mmontee/West_Lab_Hydrophone_Data_Logger/Hardware/kiCAD/IMG_20241230_154832218.jpg

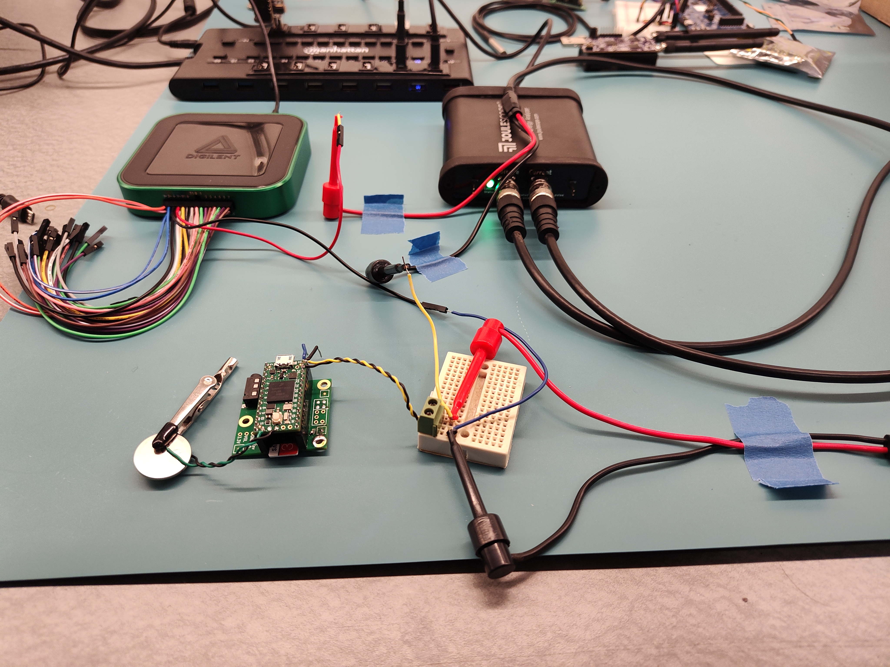
Hardware/kiCAD/IMG_20241230_154832218.jpg
