mmontee/West_Lab_Hydrophone_Data_Logger/Hardware/kiCAD/IMG_20241231_141157989.jpg

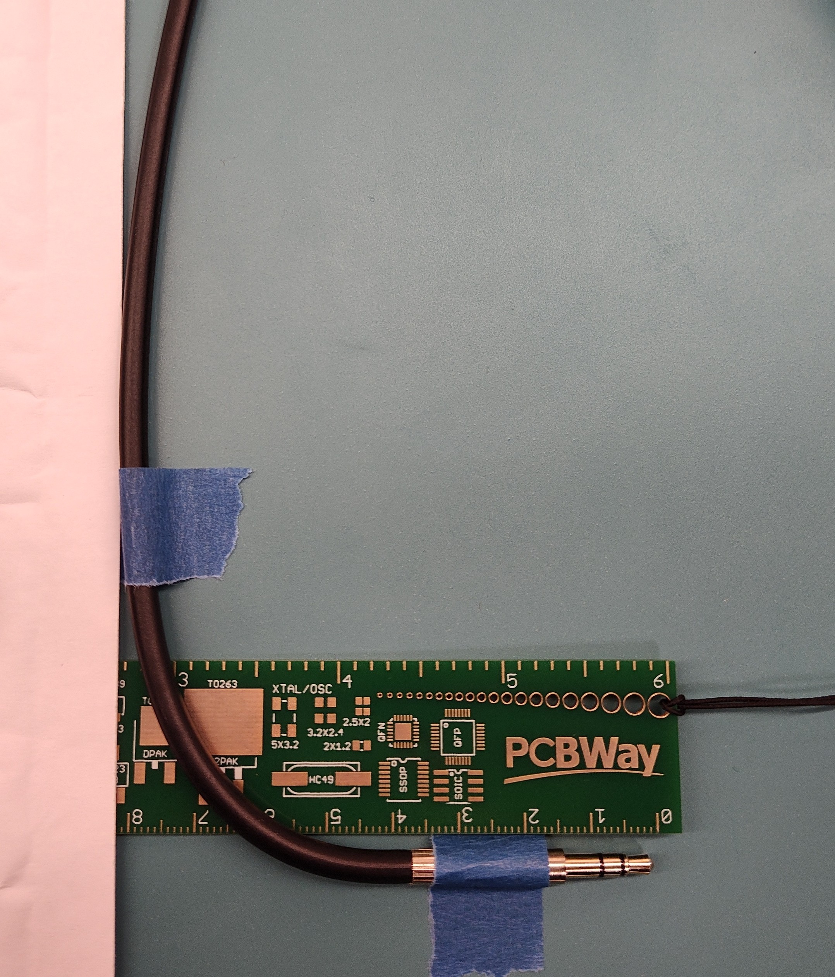
Hardware/kiCAD/IMG_20241231_141157989.jpg
