mmontee/West_Lab_Hydrophone_Data_Logger/West Lab Hydrophone Data Logger Bom .pdf

| | | | | | Total Price: | $105.50
Item | Description | Vendor | Vendor Part Number | Item Link | Quantity | Unit Price | Item(s) Price
208-4 | Dip Switch | DigiKey | CT2084-ND | 208-4 CTS Electrocomponents (https://www.digikey.com/en/products/detail/cts-electrocomponents/208-4/20783) | Switches | DigiKey 1 | $0.78 | $0.78
SJ1-3533NS | 3.5mm TRS | DigiKey | CP1-3533NS-ND | https://www.digikey.com/en/products/detail/same-sky-formerly-cui-devices/SJ1-3533NS/659904 2 | $1.59 | $3.18
2465 | Adafruit Powerboost 1A | DigiKey | 1528-1349-ND | https://www.digikey.com/en/products/detail/adafruit-industries-llc/2465/5356834 1 | $19.95 | $19.95
3034 | Coin Cell Retainer | DigiKey | 36-3034-ND | 3034 Keystone Electronics (https://www.digikey.com/en/products/detail/keystone-electronics/3034/4499289) | Battery Products | DigiKey 1 | $0.42 | $0.42
5035 | Main Battery (10Ah) | DigiKey | 1528-5035-ND | https://www.digikey.com/en/products/detail/adafruit-industries-llc/5035/14625568 1 | $29.95 | $29.95
CR2032 | RTC backup Battery | DigiKey | P189-ND | https://www.digikey.com/en/products/detail/panasonic-bsg/CR2032/31939 1 | $0.38 | $0.38
RK73B2ATTD104J | Resistor 100k | DigiKey | 2019-RK73B2ATTD104JTR-ND https://www.digikey.com/en/products/detail/koa-speer-electronics-inc/RK73B2ATTD104J/10236578 5 | $0.10 | $0.50
RK73B2ATTD471J JS202011CQN | Resistor 470 DigiKey Slide Switch DigiKey | 2019-RK73B2ATTD471JTR-ND https://www.digikey.com/en/products/detail/koa-speer-electronics-inc/RK73B2ATTD471J/10236598 2 401-2001-ND | https://www.digikey.com/en/products/detail/c-k/JS202011CQN/1640097 1 | $0.10 $0.83 | $0.20 $0.83
PPTC141LFBN-RC Pin Header DigiKey 150080RS75000 LED(Red) DigiKey | | S7012-ND 732-4984-2-ND | https://www.digikey.com/en/products/detail/sullins-connector-solutions/PPTC141LFBN-RC/810152 2 https://www.digikey.com/en/products/detail/w%C3%BCrth-elektronik/150080RS75000/4489918 2 | $0.83 $0.17 | $1.66 $0.34
| SD Card Amazon
150080GS75000 | LED(Green) | DigiKey | 732-4983-2-ND | https://www.digikey.com/en/products/detail/w%C3%BCrth-elektronik/150080GS75000/4489915 2 | $0.17 | $0.34
TEENSY40 | Micro Processor | PJRC | TEENSY40 | https://www.pjrc.com/store/teensy40.html 1 | $23.80 | $23.80
TEENSY4_AUDIO | Audio Adaptor Board | PJRC | TEENSY4_AUDIO | https://www.pjrc.com/store/teensy3_audio.html 1 | $9.80 | $9.80
CR2032 | Battery | DigiKey | P189-ND | https://www.digikey.com/en/products/detail/panasonic-bsg/CR2032/31939 1 | $0.38 | $0.38
P-SDU64GX2U3100EX-GE | PNY 64GB Elite-X Class 10 U3 V30 microSDXC Flash Memory Card 2-Pack - 100MB/s, Class 10, U3, V30, A1, 4K UHD, Full HD, UHS-I, Micro SD https://www.amazon.com/dp/B087N3B9CR 1 $12.99 $12.99
