mmontee/West_Lab_Hydrophone_Data_Logger/Hardware/kiCAD/SJ1_3533NS-3.5LRS/SJ1-3533NS.step

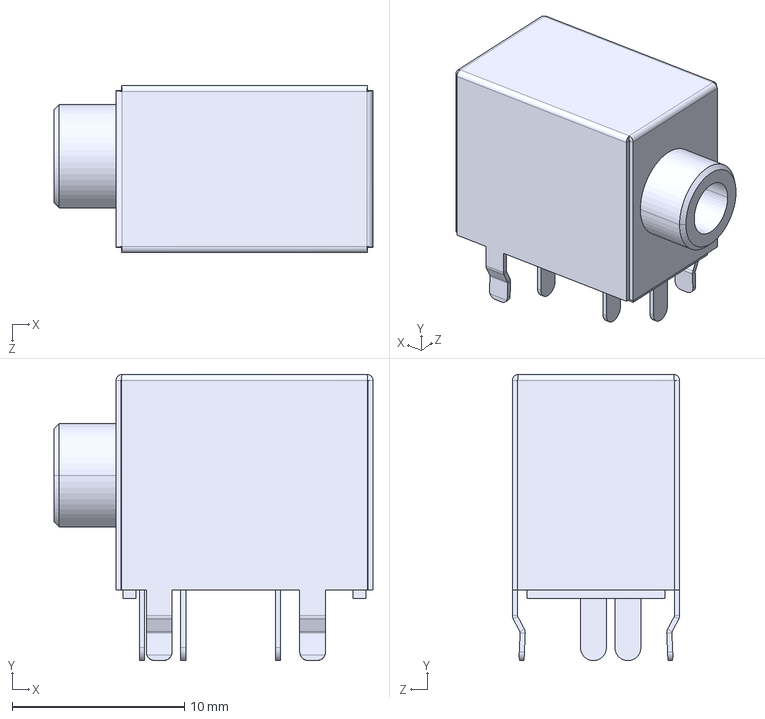
[picture p4: CAD file, 2025-04-19]
Hardware/kiCAD/SJ1_3533NS-3.5LRS/SJ1-3533NS.step
18.5 x 16.6 x 9.70 mm
