mmontee/West_Lab_Hydrophone_Data_Logger/Hardware/kiCAD/DataLogger.kicad_pcb

## KiCad design Hardware/kiCAD/DataLogger.kicad_pcb (2025-04-27)

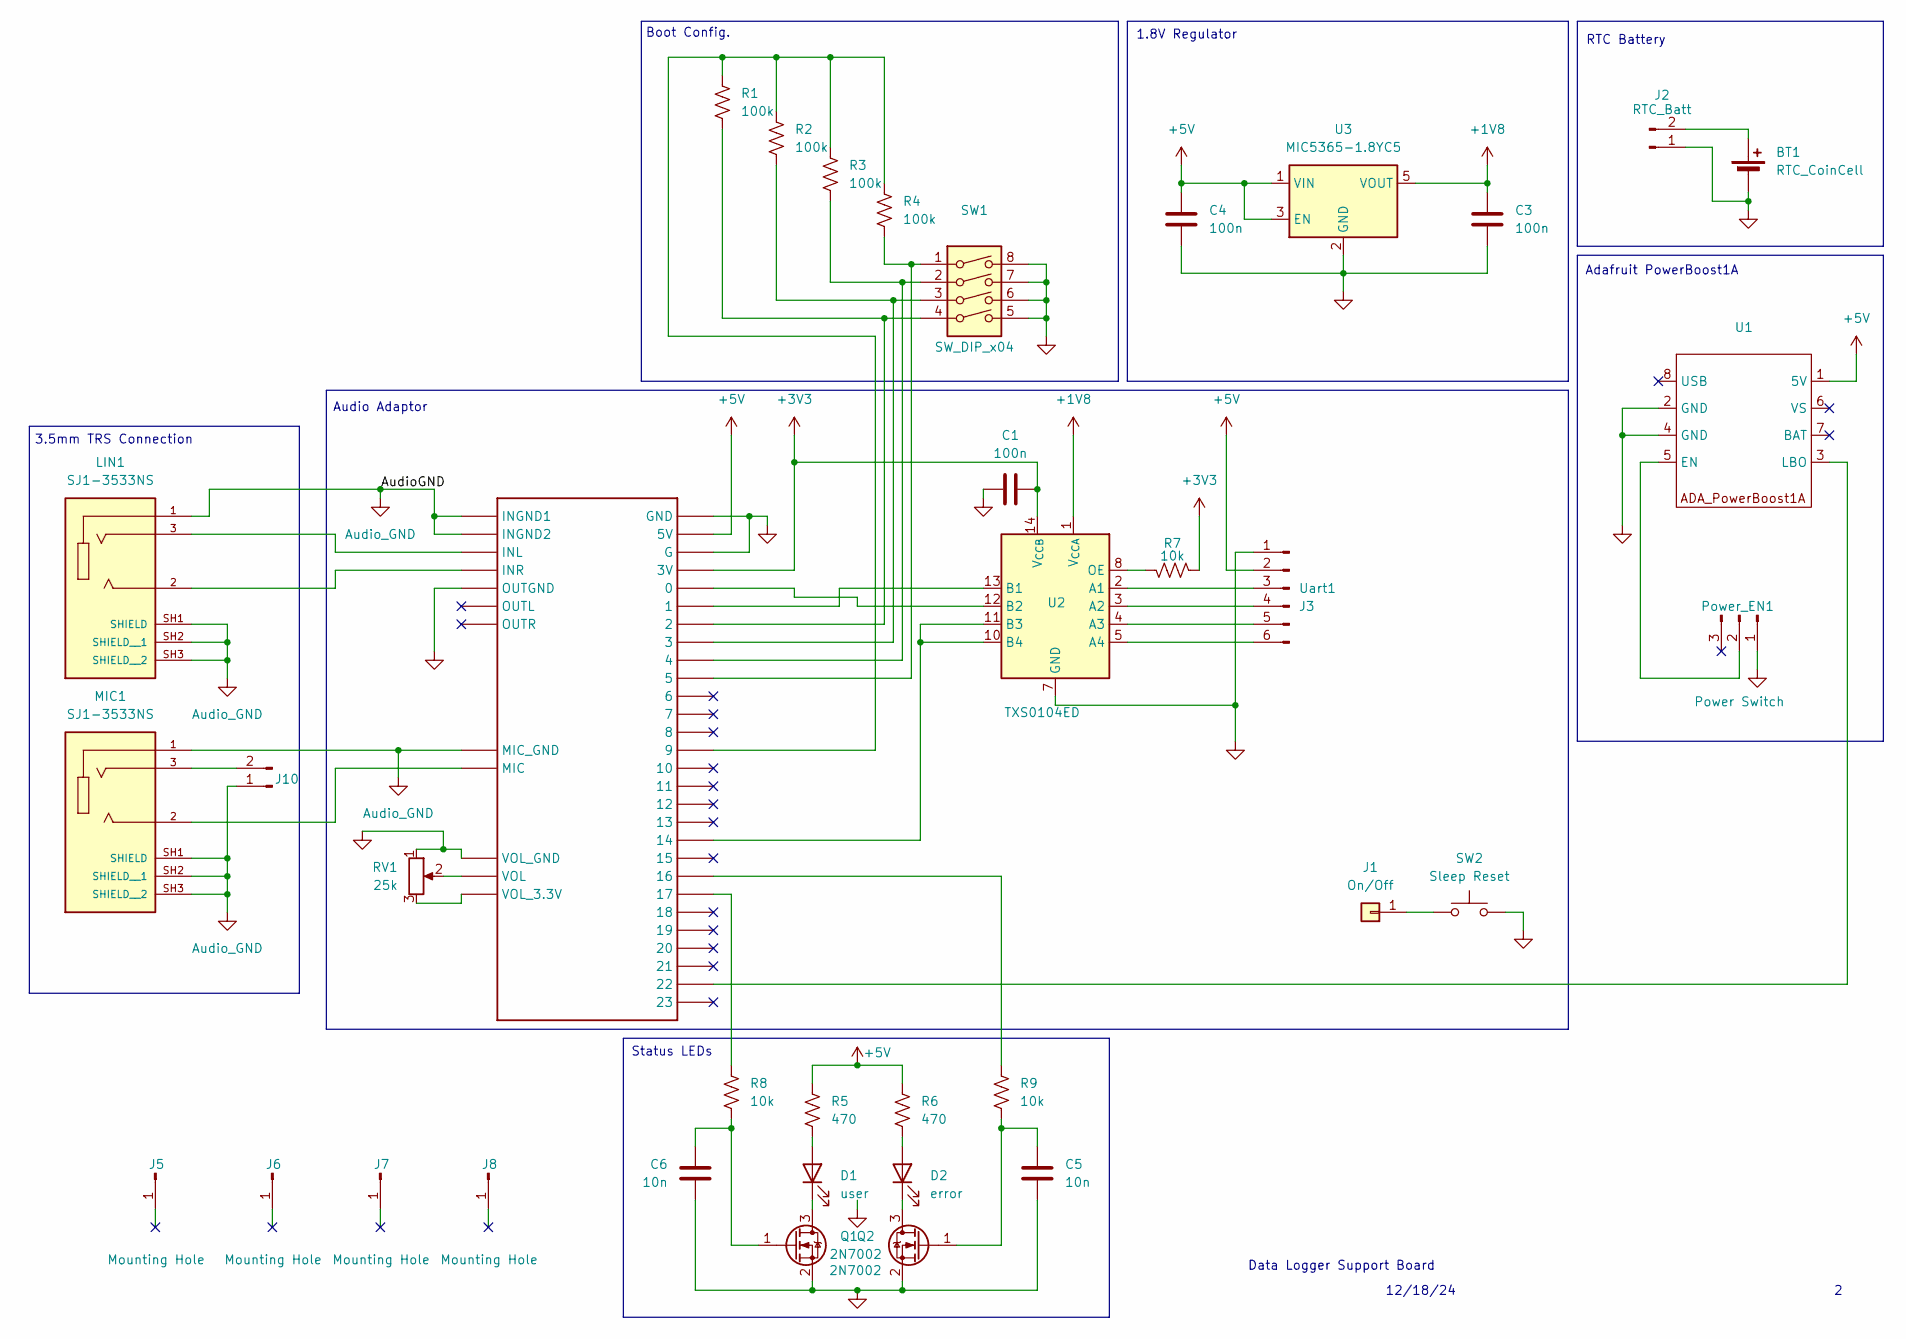
[picture p5: schematic DataLogger.kicad_sch]

Parts:
BT1: RTC_CoinCell; BatteryHolder_Keystone_3034_1x20mm
C1, C3, C4: 100n; C_0805_2012Metric_Pad1.18x1.45mm_HandSolder
C5, C6: 10n; C_0805_2012Metric_Pad1.18x1.45mm_HandSolder
D1: user; LED_0805_2012Metric_Pad1.15x1.40mm_HandSolder
D2: error; LED_0805_2012Metric_Pad1.15x1.40mm_HandSolder
J1: On/Off; PinSocket_1x01_P2.54mm_Vertical
J2: RTC_Batt; PinHeader_1x02_P2.54mm_Vertical
J3: Uart1; PinHeader_1x06_P2.54mm_Vertical
J5, J6, J7, J8: Mounting Hole; MountingHole_3.2mm_M3_Pad_Via
J10: Conn_01x02_Pin; SolderJumper-2_P1.3mm_Open_RoundedPad1.0x1.5mm
LIN1: SJ1-3533NS; CUI_SJ1-3533NS; PARTREV 1.04
MIC1: SJ1-3533NS; CUI_SJ1-3533NS; PARTREV 1.04
Power_EN1: Power Switch; SW_CK_JS202011CQN_DPDT_Straight
Q1, Q2: 2N7002; SOT-23
R1, R2, R3, R4: 100k; R_0805_2012Metric_Pad1.20x1.40mm_HandSolder
R5, R6: 470; R_0805_2012Metric_Pad1.20x1.40mm_HandSolder
R7, R8, R9: 10k; R_0805_2012Metric_Pad1.20x1.40mm_HandSolder
RV1: 25k
SW1: SW_DIP_x04; DIP8_208-4_CTS
SW2: Sleep Reset; SW_SPST_PTS647_Sx38
T1: AUDIOSHIELD
U1: ADA_powerBoost1A
U2: TXS0104ED; SOIC-14_3.9x8.7mm_P1.27mm
U3: MIC5365-1.8YC5; SOT-353_SC-70-5

Connections:
+1V8: C3.2, U2.1 (V_{CCA}), U3.5 (VOUT)
+3V3: C1.2, R7.1, T1.3V, U2.14 (V_{CCB})
+5V: C4.1, J3.2, R5.1, R6.1, T1.5V, U1.1 (5V), U3.1 (VIN), U3.3 (EN)
Audio_GND: J10.1, LIN1.1, LIN1.SH1 (SHIELD), LIN1.SH2 (SHIELD__1), LIN1.SH3 (SHIELD__2), MIC1.1, MIC1.SH1 (SHIELD), MIC1.SH2 (SHIELD__1), MIC1.SH3 (SHIELD__2), T1.GND_MIC (MIC_GND), T1.INGND1, T1.INGND2
GND: BT1.2 (-), C1.1, C3.1, C4.2, C5.1, C6.1, J2.1, J3.1, Power_EN1.1, Q1.2 (S), Q2.2 (S), RV1.1, SW1.5, SW1.6, SW1.7, SW1.8, SW2.2, T1.G, T1.GND, T1.OUTGND, T1.VOL_GND, U1.2 (GND), U1.4 (GND), U2.7 (GND), U3.2 (GND)
unnamed: BT1.1 (+), J2.2
unnamed: D1.2 (A), R5.2
unnamed: D1.1 (K), Q1.3 (D)
unnamed: D2.2 (A), R6.2
unnamed: D2.1 (K), Q2.3 (D)
unnamed: J1.1, SW2.1
unnamed: J3.3, U2.2 (A1)
unnamed: J3.4, U2.3 (A2)
unnamed: J3.5, U2.4 (A3)
unnamed: J3.6, U2.5 (A4)
unnamed: J10.2, MIC1.3
unnamed: LIN1.2, T1.INR
unnamed: LIN1.3, T1.INL
unnamed: MIC1.2, T1.MIC
unnamed: Power_EN1.2, U1.5 (EN)
unnamed: C6.2, Q1.1 (G), R8.2
unnamed: C5.2, Q2.1 (G), R9.2
unnamed: R1.1, R2.1, R3.1, R4.1, T1.9
unnamed: R1.2, SW1.4, T1.2
unnamed: R2.2, SW1.3, T1.3
unnamed: R3.2, SW1.2, T1.4
unnamed: R4.2, SW1.1, T1.5
unnamed: R8.1, T1.17
unnamed: R9.1, T1.16
unnamed: RV1.2, T1.VOL
unnamed: RV1.3, T1.VOL_3.3V
unnamed: T1.22, U1.3 (LBO)
unnamed: T1.1, U2.13 (B1)
unnamed: T1.0, U2.12 (B2)
unnamed: T1.14, U2.10 (B4), U2.11 (B3)
unnamed: R7.2, U2.8 (OE)

Notes on the sheet:
Status LEDs
3.5mm TRS Connection
12/18/24
Adafruit PowerBoost1A
RTC Battery
Audio Adaptor
Boot Config.
1.8V Regulator
Data Logger Support Board

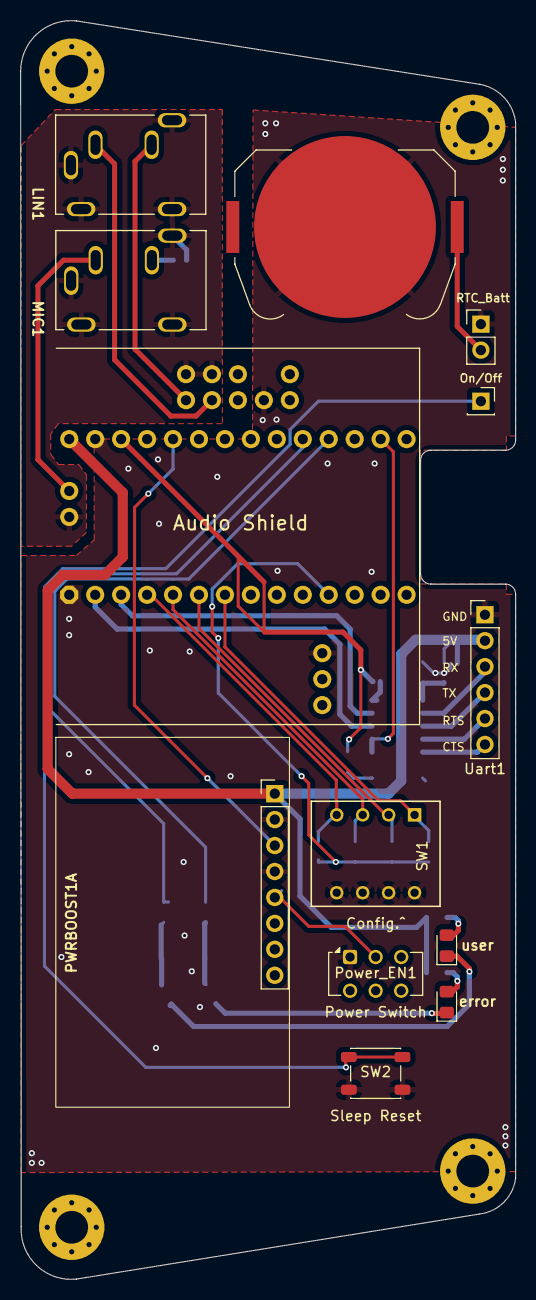
[picture p6: board DataLogger.kicad_pcb from above]

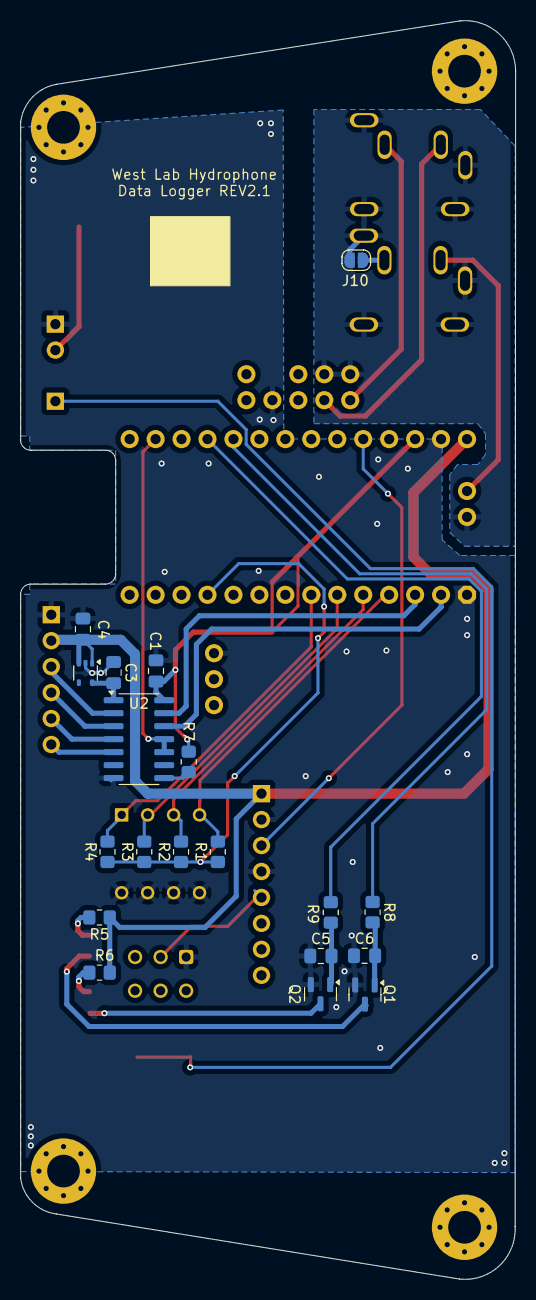
[picture p7: board DataLogger.kicad_pcb from below]

Board: 2 copper layers, 48.4 x 123.2 mm, 36 parts (19 on the bottom side), 34 nets.
