mmontee/West_Lab_Hydrophone_Data_Logger/(commit log)

2025-01-05 KiCAD Project upload
    [DataLoggerRev1.kicad_pcb, DataLoggerRev1.kicad_sch]
2025-01-08 BOM upload
2025-01-08 Rename West Lab Hydrophone Data Logger Bom - Sheet1.pdf to West Lab Hydrophone Data Logger Bom .pdf
2025-04-19 Rev2 Hardware
    [DataLogger.kicad_pcb, DataLogger.kicad_sch, DataLoggerRev1.kicad_pcb, DataLoggerRev1.kicad_sch, SJ1-3533NS.step]
2025-04-27 TXS0104ED wiring fix and layout adjustments for improved SD card access. REV2.1
    [DataLogger.kicad_pcb, DataLogger.kicad_sch]
